PugFoPrez/Tactile-Sensor-Data-Acquisition-System/component_models/LoadCellWiringBoard.3mf

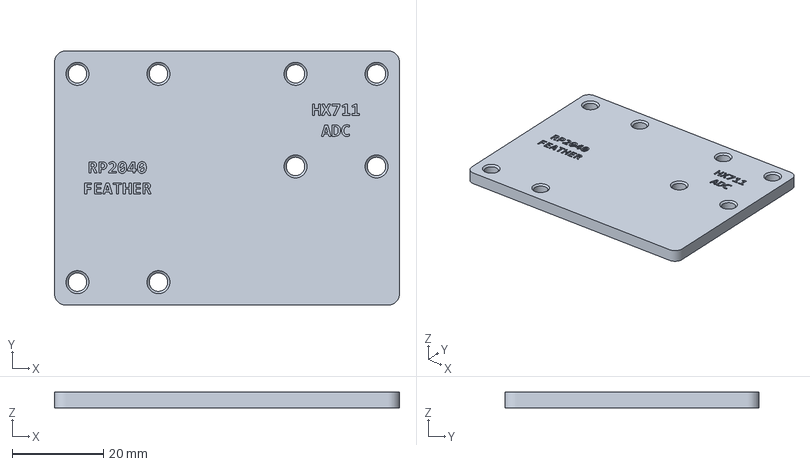
[picture p1: CAD file, 2026-10-23]
component_models/LoadCellWiringBoard.3mf
75.7 x 55.8 x 3.50 mm
