PugFoPrez/Tactile-Sensor-Data-Acquisition-System/component_models/ProbeHolderFront.stl

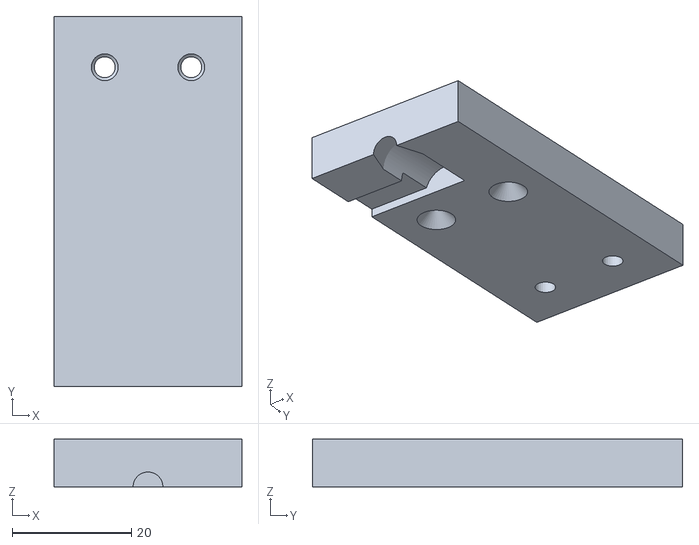
[picture p2: CAD file, 2026-10-23]
component_models/ProbeHolderFront.stl
31.5 x 62.0 x 8.00
