PugFoPrez/Tactile-Sensor-Data-Acquisition-System/component_models/ProbingTips.3mf

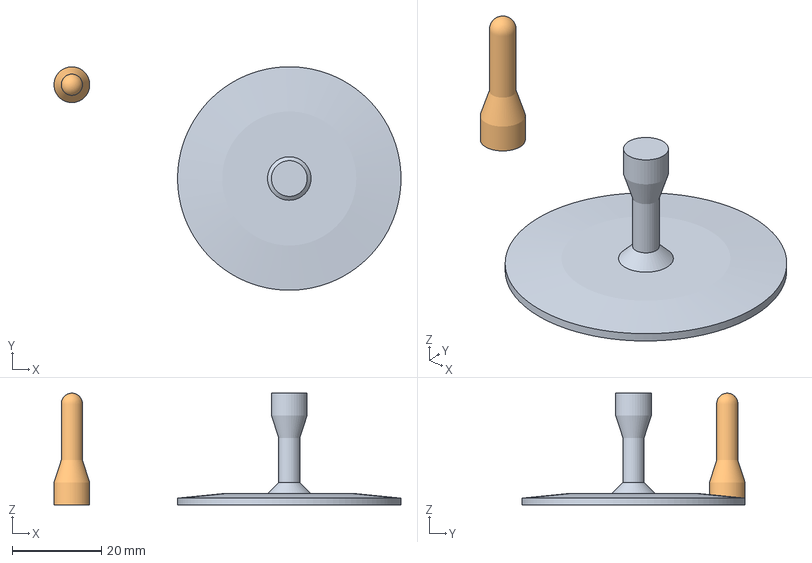
[picture p3: CAD file, 2026-10-23]
component_models/ProbingTips.3mf
77.7 x 50.0 x 25.0 mm
ProbingTipFlat.stl
ProbingTipSphere.stl
