PugFoPrez/Tactile-Sensor-Data-Acquisition-System/component_models/ProbeHolderBack.stl

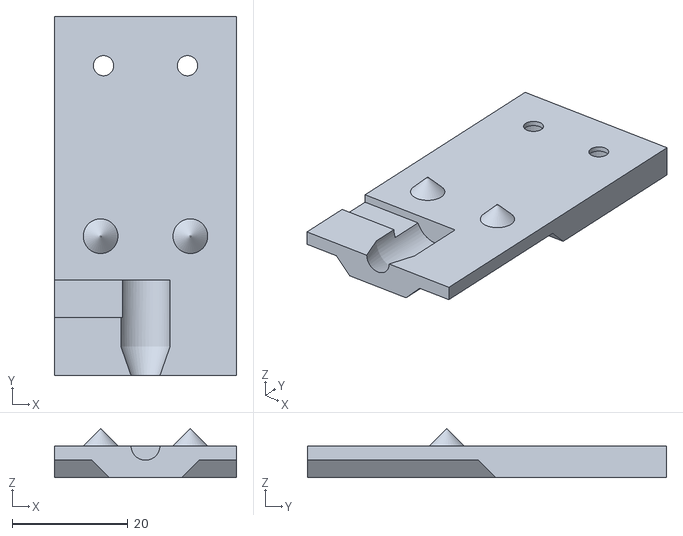
[picture p4: CAD file, 2026-10-23]
component_models/ProbeHolderBack.stl
31.5 x 62.0 x 8.50
