PugFoPrez/Tactile-Sensor-Data-Acquisition-System/component_models/ProbingTipFlat.stl

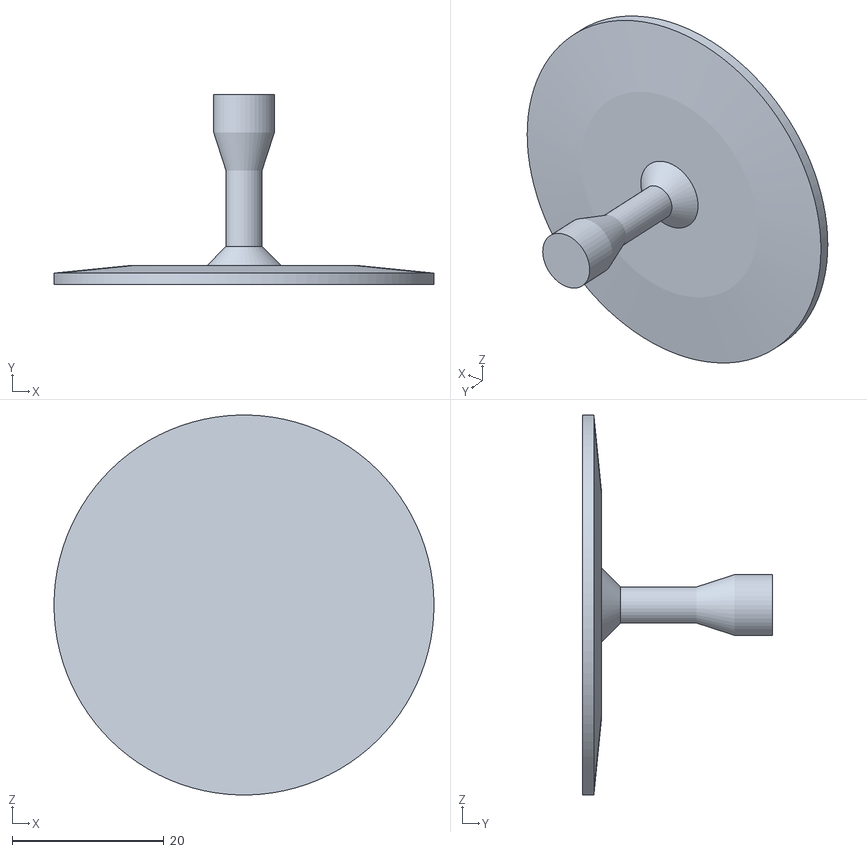
[picture p5: CAD file, 2026-10-23]
component_models/ProbingTipFlat.stl
50.0 x 25.0 x 50.0
