PugFoPrez/Tactile-Sensor-Data-Acquisition-System/component_models/ProbeHolder.3mf

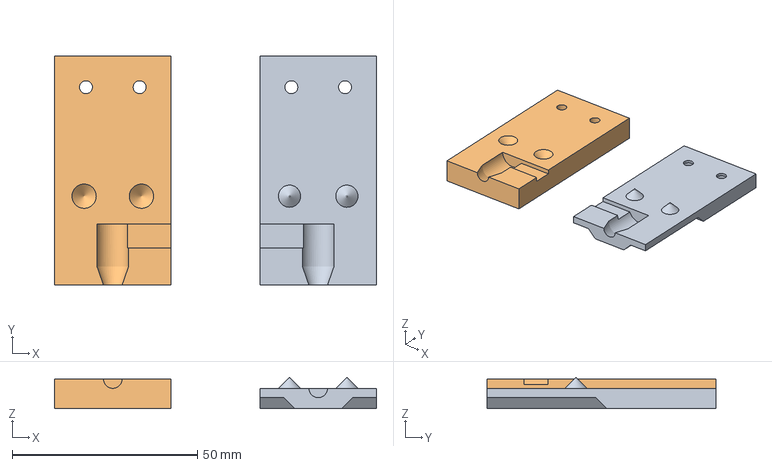
[picture p6: CAD file, 2026-10-23]
component_models/ProbeHolder.3mf
87.0 x 62.0 x 8.50 mm
ProbeHolderBack.stl
ProbeHolderFront.stl
