PugFoPrez/Tactile-Sensor-Data-Acquisition-System/component_models/ProbingTipSphere.stl

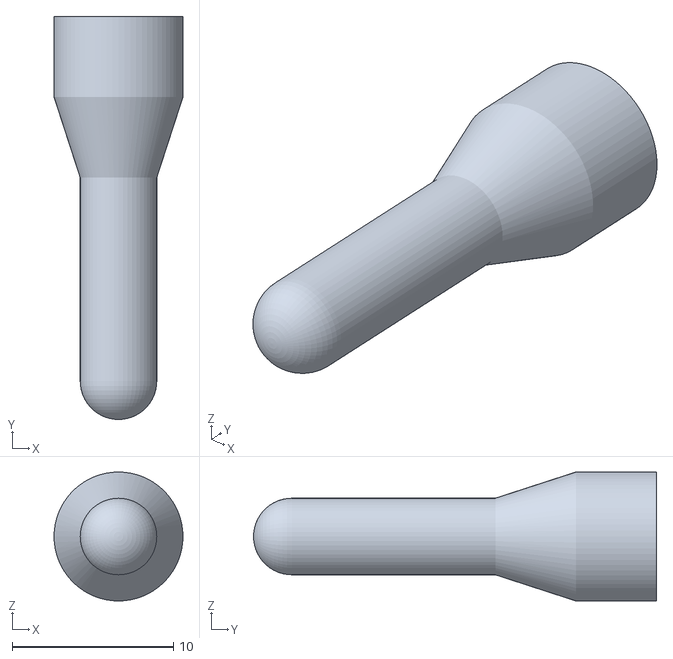
[picture p7: CAD file, 2026-10-23]
component_models/ProbingTipSphere.stl
8.00 x 25.0 x 8.00
