PugFoPrez/Tactile-Sensor-Data-Acquisition-System/(list of files, cad)

Other CAD files:
component_models/LoadCellWiringBoard.f3d
component_models/ProbeHolder.f3d
component_models/ProbingTip.f3d
component_models/ProbingTipFlat.f3d
component_models/ProbingTipSphere.f3d
component_models/eFleshSensorPackageHolder.f3d
