PugFoPrez/Tactile-Sensor-Data-Acquisition-System/component_drawings/Drawing Load Cell Wiring Board.pdf

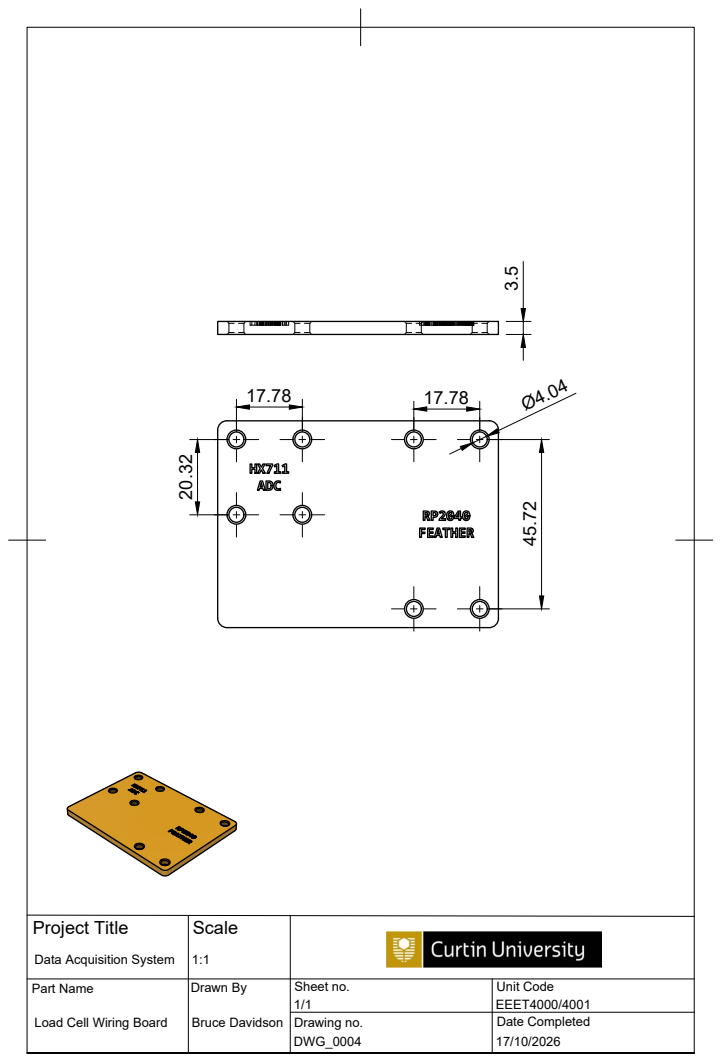
[picture p8: page 1]

Project Title Data Acquisition System | Scale 1:1

Part Name Load Cell Wiring Board | Drawn By Bruce Davidson | Sheet no. 1/1 | Unit Code EEET4000/4001

Drawing no. DWG_0004 | Date Completed
