PugFoPrez/Tactile-Sensor-Data-Acquisition-System/component_drawings/Drawing Probe Holder.pdf

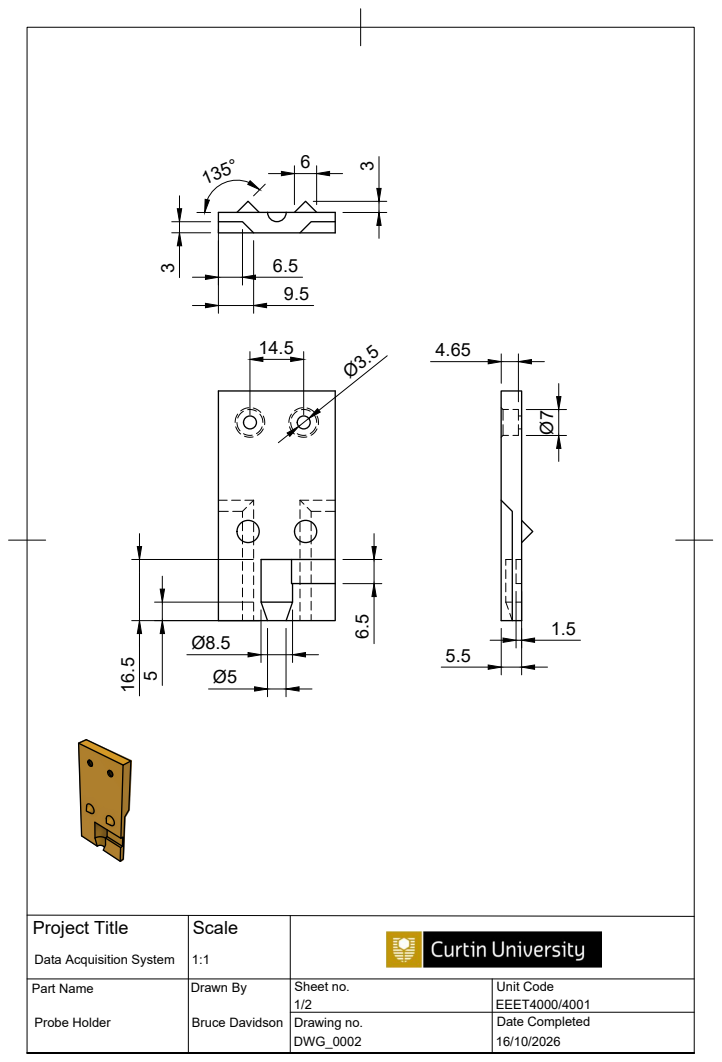
[picture p9: page 1]

Project Title Data Acquisition System | Scale 1:1

Part Name Probe Holder | Drawn By Bruce Davidson | Sheet no. 1/2 | Unit Code EEET4000/4001

Drawing no. DWG_0002 | Date Completed

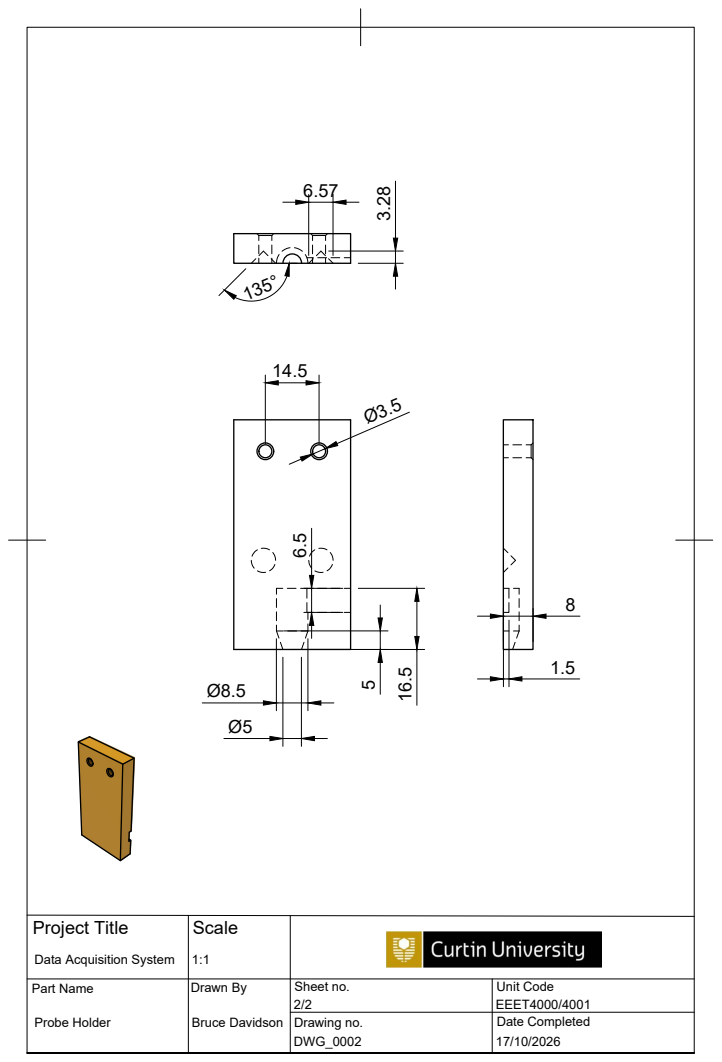
[picture p10: page 2]

Project Title Data Acquisition System | Scale 1:1

Part Name Probe Holder | Drawn By Bruce Davidson | Sheet no. 2/2 | Unit Code EEET4000/4001

Drawing no. DWG_0002 | Date Completed 17/10/2026
