PugFoPrez/Tactile-Sensor-Data-Acquisition-System/component_drawings/Drawing Probe Tip Base.pdf

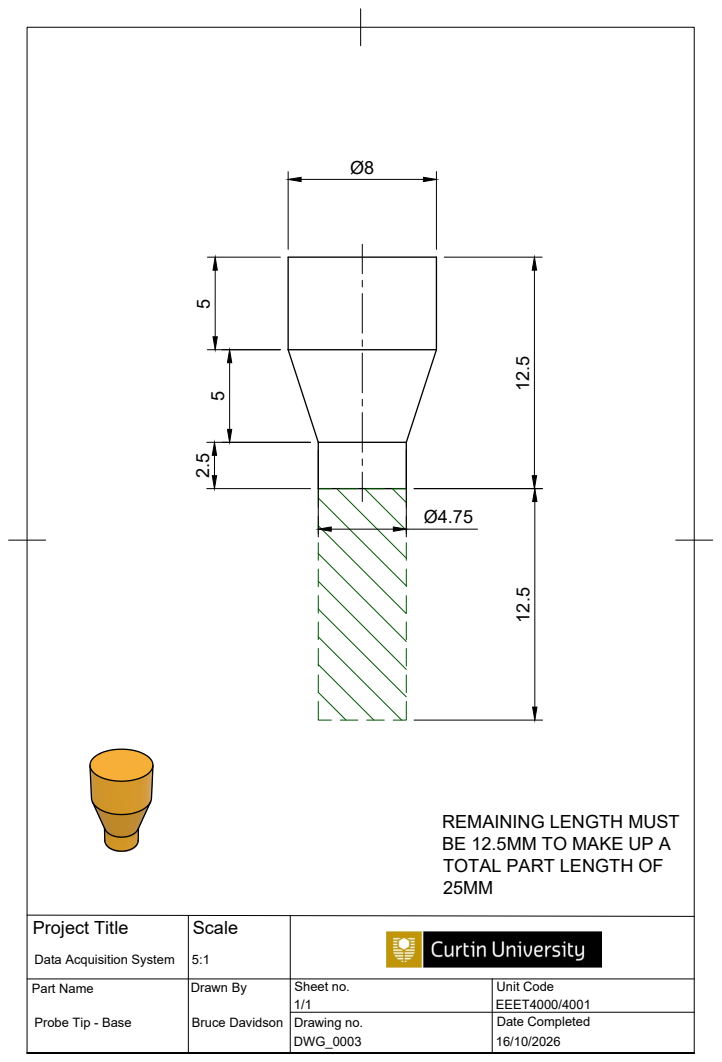
[picture p11: page 1]

REMAINING LENGTH MUST
BE 12.5MM TO MAKE UP A
TOTAL PART LENGTH OF

Project Title Data Acquisition System | Scale 5:1

Part Name Probe Tip - Base | Drawn By Bruce Davidson | Sheet no. 1/1 | Unit Code EEET4000/4001

Drawing no. DWG_0003 | Date Completed 16/10/2026
