PugFoPrez/Tactile-Sensor-Data-Acquisition-System/component_drawings/Drawing Probe Tip Flat.pdf

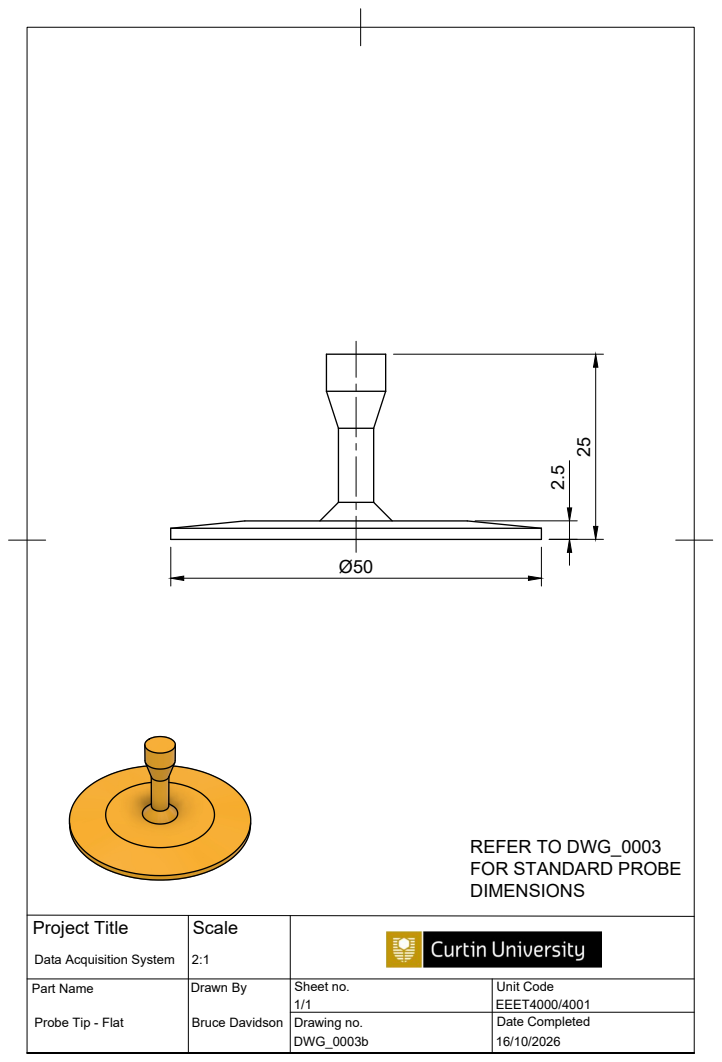
[picture p12: page 1]

REFER TO DWG_0003
FOR STANDARD PROBE
DIMENSIONS

Project Title Data Acquisition System | Scale 2:1

Part Name Probe Tip - Flat | Drawn By Bruce Davidson | Sheet no. 1/1 | Unit Code EEET4000/4001

Drawing no. DWG_0003b | Date Completed 16/10/2026
