PugFoPrez/Tactile-Sensor-Data-Acquisition-System/component_drawings/Drawing Probe Tip Point.pdf

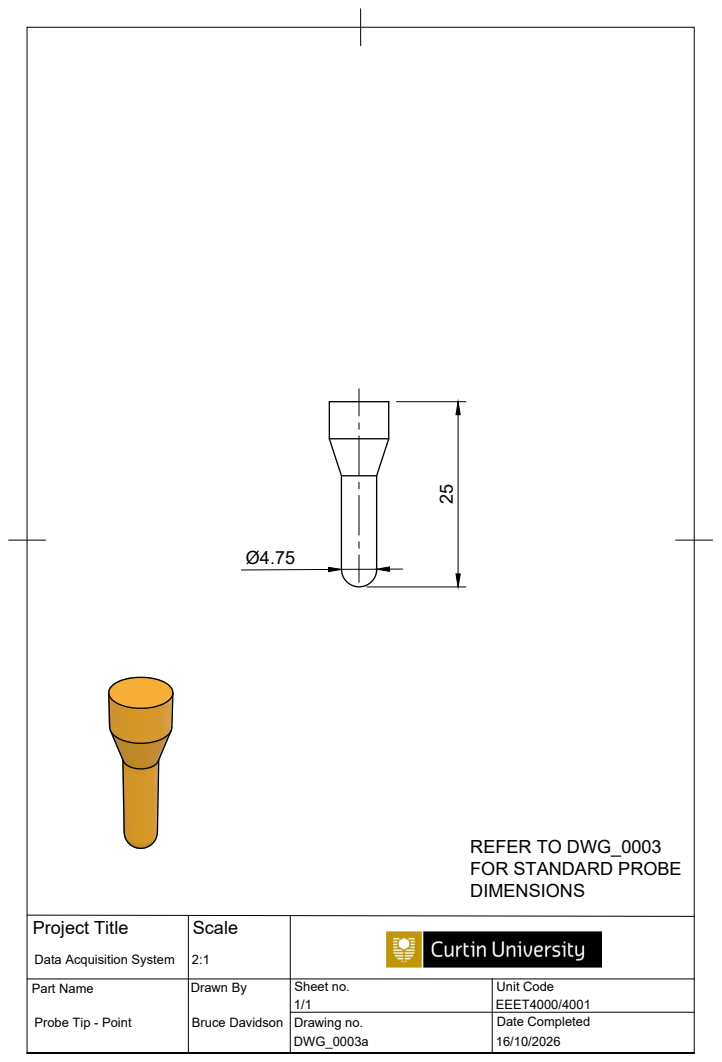
[picture p13: page 1]

REFER TO DWG_0003
FOR STANDARD PROBE
DIMENSIONS

Project Title Data Acquisition System | Scale 2:1

Part Name Probe Tip - Point | Drawn By Bruce Davidson | Sheet no. 1/1 | Unit Code EEET4000/4001

Drawing no. DWG_0003a | Date Completed
