PugFoPrez/Tactile-Sensor-Data-Acquisition-System/component_drawings/Drawing eFlesh Hold-Down Fixture.pdf

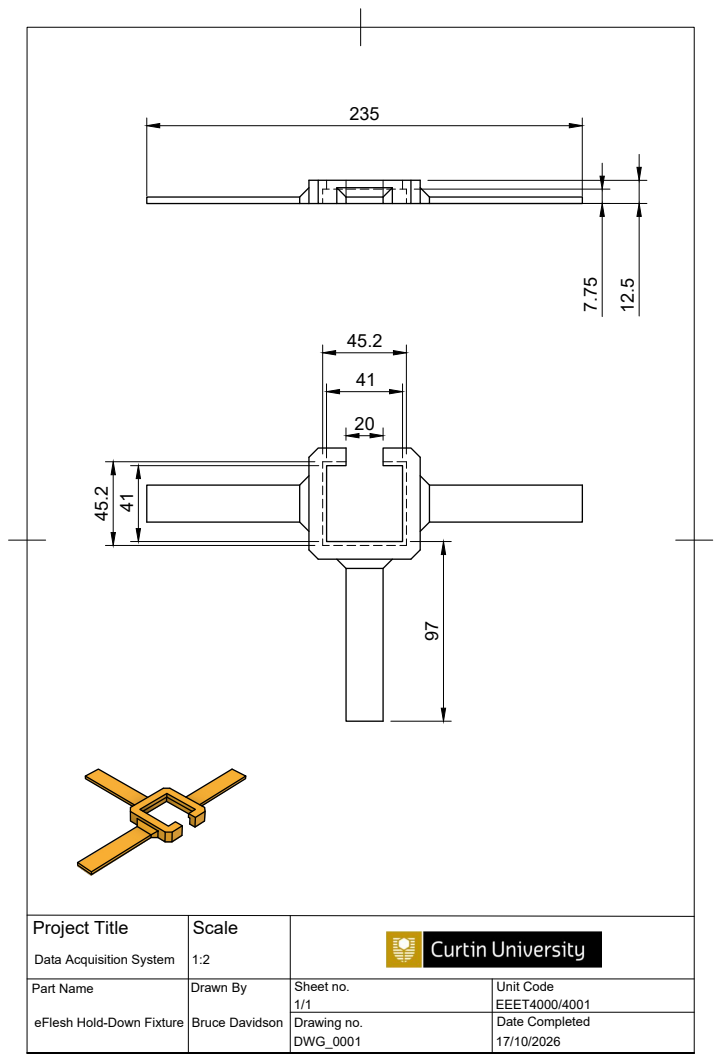
[picture p14: page 1]

Project Title Data Acquisition System | Scale 1:2

Part Name eFlesh Hold-Down Fixture | Drawn By Bruce Davidson | Sheet no. 1/1 | Unit Code EEET4000/4001

Drawing no. DWG_0001 | Date Completed 17/10/2026
