PugFoPrez/Tactile-Sensor-Data-Acquisition-System/component_drawings/Drawing ref_eFlesh Sensor Package.pdf

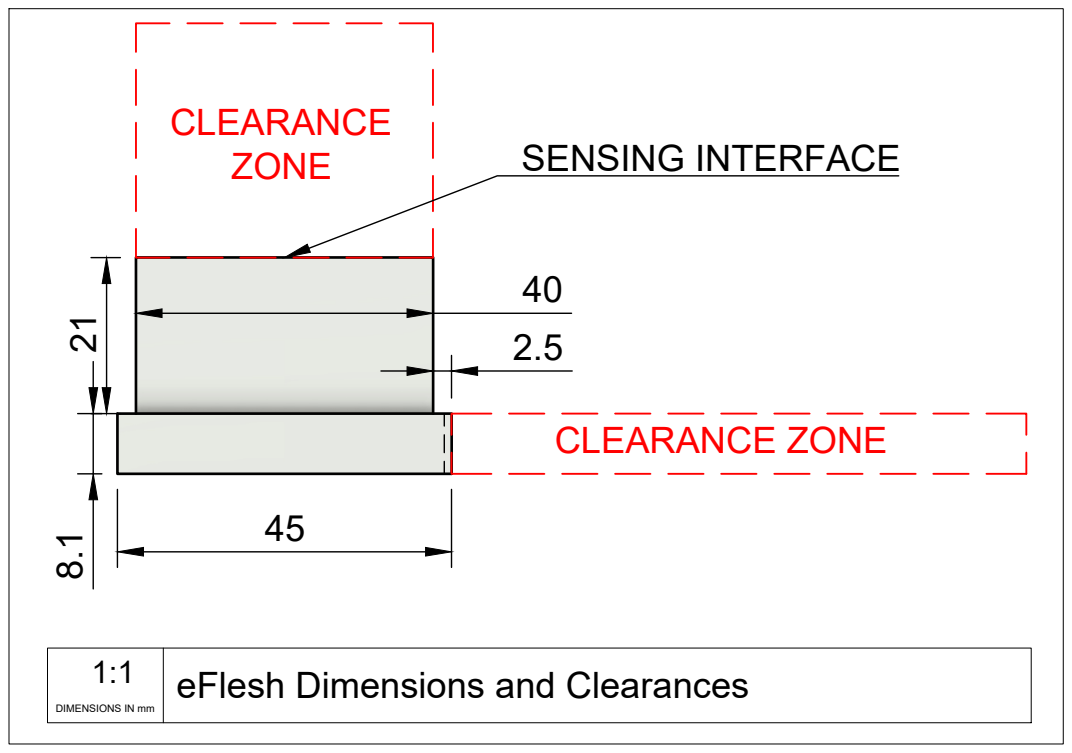
[picture p15: page 1]
CLEARANCE ZONE; DIMENSIONS IN mm; eFlesh Dimensions and Clearances 1:1; SENSING INTERFACE
