PugFoPrez/Tactile-Sensor-Data-Acquisition-System/component_drawings/Drawing ref_Ender3ToolHead.pdf

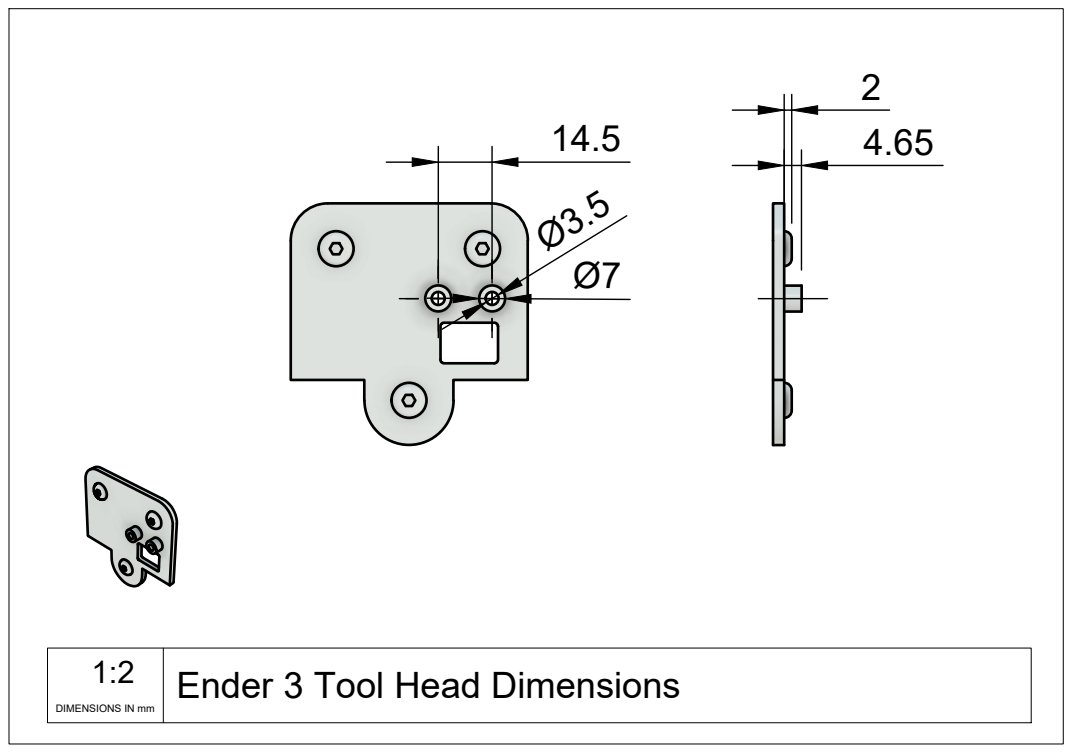
[picture p16: page 1]
DIMENSIONS IN mm; Ender 3 Tool Head Dimensions 1:2
