PugFoPrez/Tactile-Sensor-Data-Acquisition-System/component_drawings/Drawing ref_Load Cell.pdf

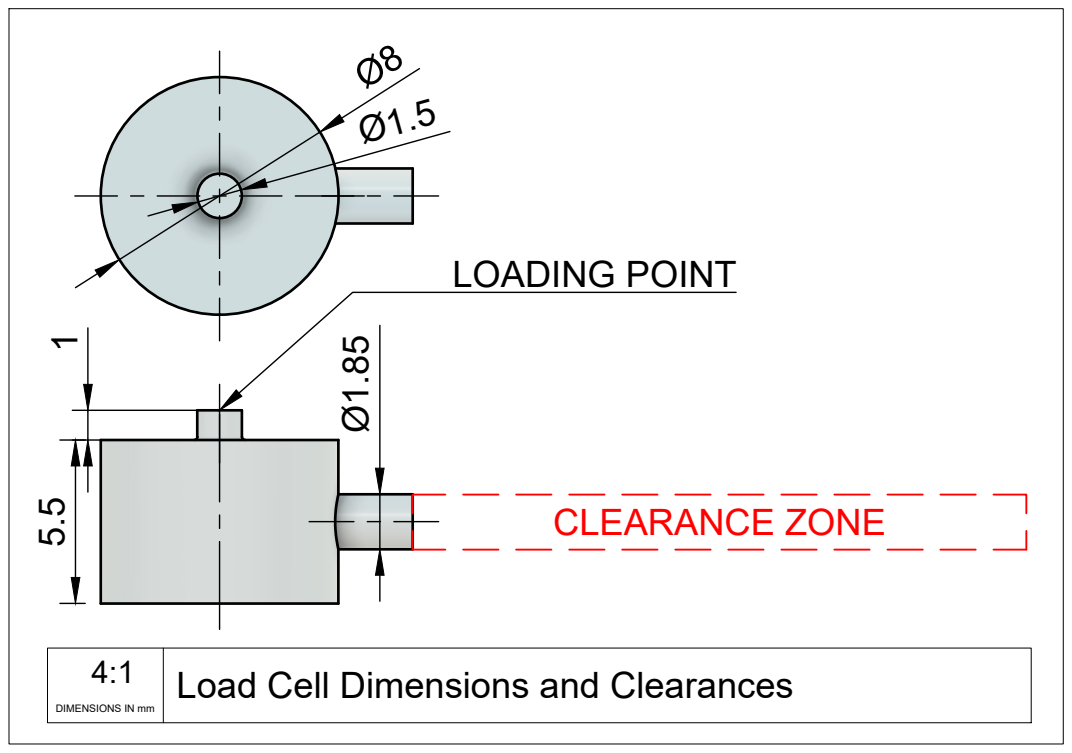
[picture p17: page 1]
CLEARANCE ZONE; DIMENSIONS IN mm; Load Cell Dimensions and Clearances 4:1; LOADING POINT
