PugFoPrez/Tactile-Sensor-Data-Acquisition-System/manipulation.py

#!/usr/bin/env python3
#
# Created by Bruce Davidson - Curtin University
#
# Created:       12th May 2026
# Last Modified: 21st Sep 2026 (Bruce Davidson)
#
# manipulation.py
# This script handles formatting of CNC machine behaviours into appropriate gcode commands.

import export
import math
import configuration as conf

hopHeight = conf.param("cnc.hopHeight")
feedrateXY = conf.param("cnc.feedrate.XY")
feedrateZ = conf.param("cnc.feedrate.Z")

sysMin = conf.param("cnc.min")
sysMax = conf.param("cnc.max")

def comment(text):
    """This formats and adds the provided text as a gcode comment, and then exports it.

    Args:
        text (String): The gcode comment (Without ";")
    """
    export.send(f"; {text}")

def move(x, y, z, rel=False, hop=True, blockingWait=True):
    """This function moves the toolhead to the specified position, either relative to the current position or to an absolute position.
    A hop is by default enabled to ensure that it doesn't drag the toolhead along flat surfaces.

    Args:
        x (float): The destination X position
        y (float): The destination Y position
        z (float): The destination Z position
        rel (bool, optional): Whether the movement should be done relative to the toolhead's position (True) or done in absolute positioning (False). Defaults to False.
        hop (bool, optional): Whether a hop should be enabled for the movement. Defaults to True.
        blockingWait (Bool): Whether the machine should wait for the move to complete before returning - Note this uses non-blocking communication and may cause synchronisation issues!.
    """
    if hop:
        export.send(f"G91\nG1 Z{hopHeight:.2f} F{feedrateZ:.2f}", blockingWait=blockingWait)

    feedrate = math.sqrt(pow(feedrateXY, 2) + pow(feedrateZ, 2))

    locX = f"X{x:2f} " if x != None else ""
    locY = f"Y{y:2f} " if y != None else ""
    if not hop:
       locZ = f"Z{z:2f} " if z != None else ""
    else:
       if not rel:
           locZ = f"Z{z+hopHeight:2f} " if z != None else ""
       else:
           locZ = f"Z{z:2f} " if z != None else ""

    if (rel):
        export.send(f"G91\nG1 {locX}{locY}{locZ}F{feedrate:.2f}", blockingWait=blockingWait)
    else:
        export.send(f"G90\nG1 {locX}{locY}{locZ}F{feedrate:.2f}", blockingWait=blockingWait)

    if hop:
        export.send(f"G91\nG1 Z-{hopHeight:.2f} F{feedrateZ:.2f}", blockingWait=blockingWait)

def home():
    """Homes the 3D printer to (0,0,0)
    """
    export.send("M107 P1 ; Turn off part fan")
    export.send("G91\nG1 Z20")
    export.send("G28 X Y")
    export.send("G28 Z")

def dwell(time=1):
    """Pauses the printer for the specified amount of time.

    Args:
        time (int, optional): Time to pause for, in seconds. Defaults to 1.
    """
    export.send(f"G4 S{time}")

def setProgress(frac):
    """Sets the gcode progress based on the provided value

    Args:
        frac (float): Progress to be set. Must be in the range [0, 100]
    """
    if (frac < 0):
        frac = 0
        print("Progress cannot be negative. Clipped.")
    elif (frac > 100):
        frac = 100
        print("Progress cannot be greater than 100%. Clipped.")
    export.send(f"M73 P{frac:.0f}")
