PugFoPrez/Tactile-Sensor-Data-Acquisition-System/(commit log)

2026-05-16 Corrected progress implementation to be 0-100. Removed pycache entries
    [generator.py, manipulation.py]
2026-07-20 Printer control functioning
2026-07-23 Updated measurement code - fixed class based issues
    [generator.py, measure.py]
2026-08-04 Added user controlled calibration of load cell, and basic README structure
2026-09-03 Added loading and storing of load cell calibration
2026-09-06 Fixed errors with calibration and settings changes
    [communication.py, export.py, generator.py, measure.py]
2026-09-14 Added tip to docs, added user controlled pause between calibration and probing, added keep awake during probing,
2026-09-14 Fixed csv export from per-measurement data append change
    [measure.py]
2026-09-14 Updated eFlesh measurements to include all XYZ values from magnetometer, changed how baselines are taken
2026-09-16 Updated generator.py to continue movement down in grid probing instead of reset
    [generator.py]
2026-09-21 Fixed dwell command to use seconds, not milliseconds
    [manipulation.py]
2026-09-21 Revert "Fixed dwell command to use seconds, not milliseconds"
    This reverts commit c09d47bcf6ebf32ad7b5d88e16314feef1743ac5.
    [manipulation.py]
2026-09-21 Added parameter for random offsets to probeGrid(), and added configurable dwell times.
2026-09-22 Updated probeGrid() randomiser to keep XY consistent between Z movements
2026-09-23 Fixed random seed for y=0 values, updated keep awake to keep screen awake as well
    [generator.py]
2026-09-23 Fixed error in hop height movement calculation not accounting for hop in final Z height
    [manipulation.py]
2026-09-23 Fixed generation of random points to effect actual locations sent in command
    [generator.py]
2026-09-23 Fixed random to not accumulate offsets on the X value with each Y loop
    [generator.py]
2026-09-23 Missed global declaration for randomSeed
    [generator.py]
2026-10-19 Added implementation for multiple probing passes on ProbeGrid()
2026-10-20 Added random probe function
2026-10-23 Added CAD models and drawings to repository
